Der1va/Flight/tmp/pdfs/schematic/page_1.png

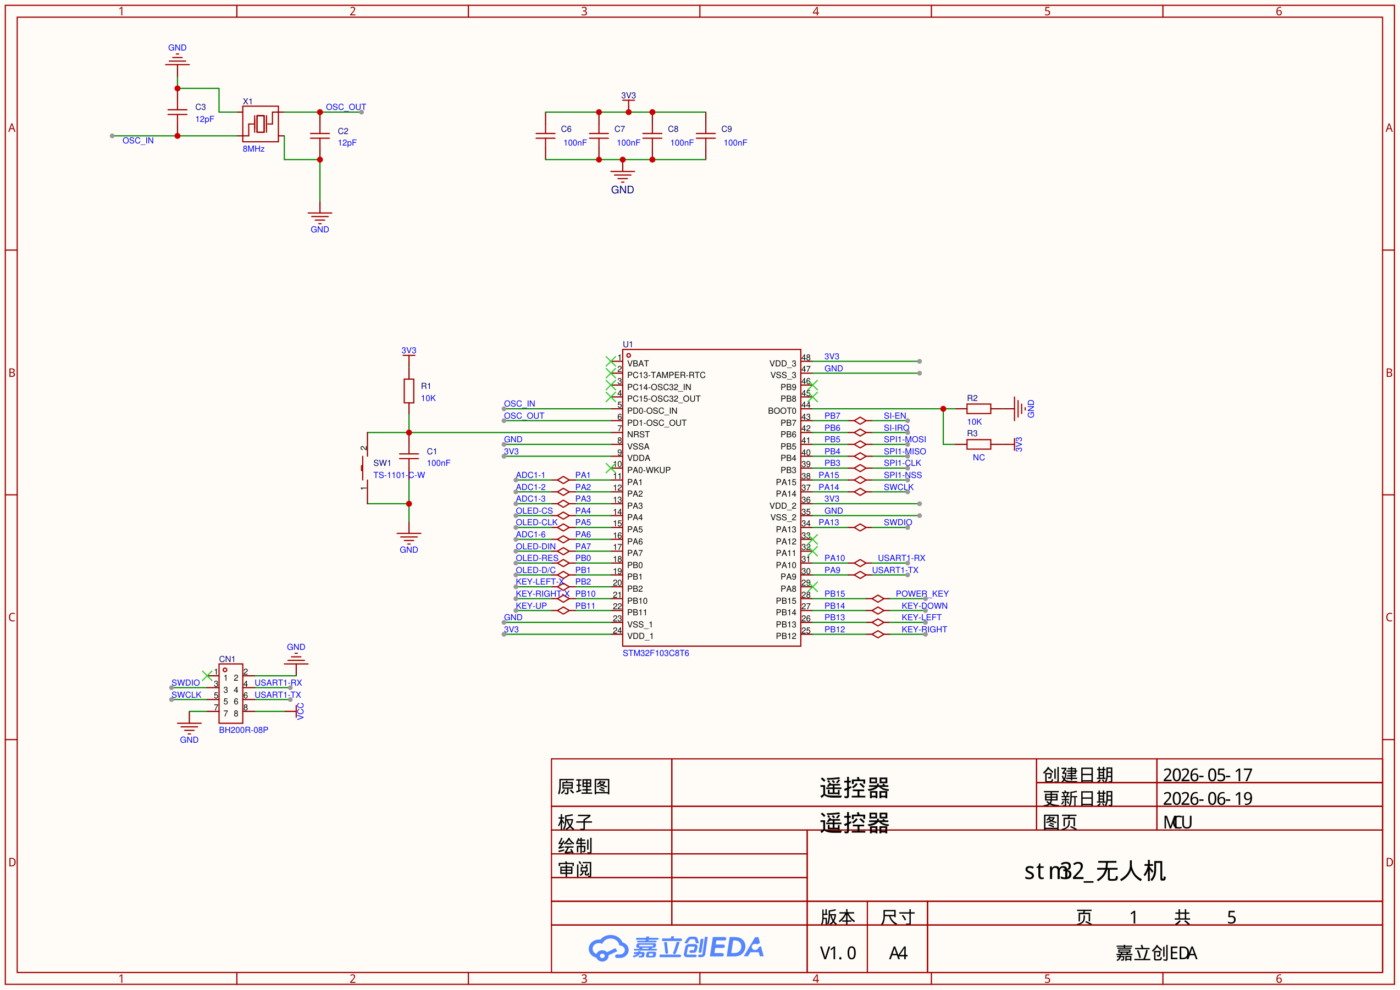
tmp/pdfs/schematic/page_1.png
