Der1va/Flight/tmp/pdfs/schematic/page_2.png

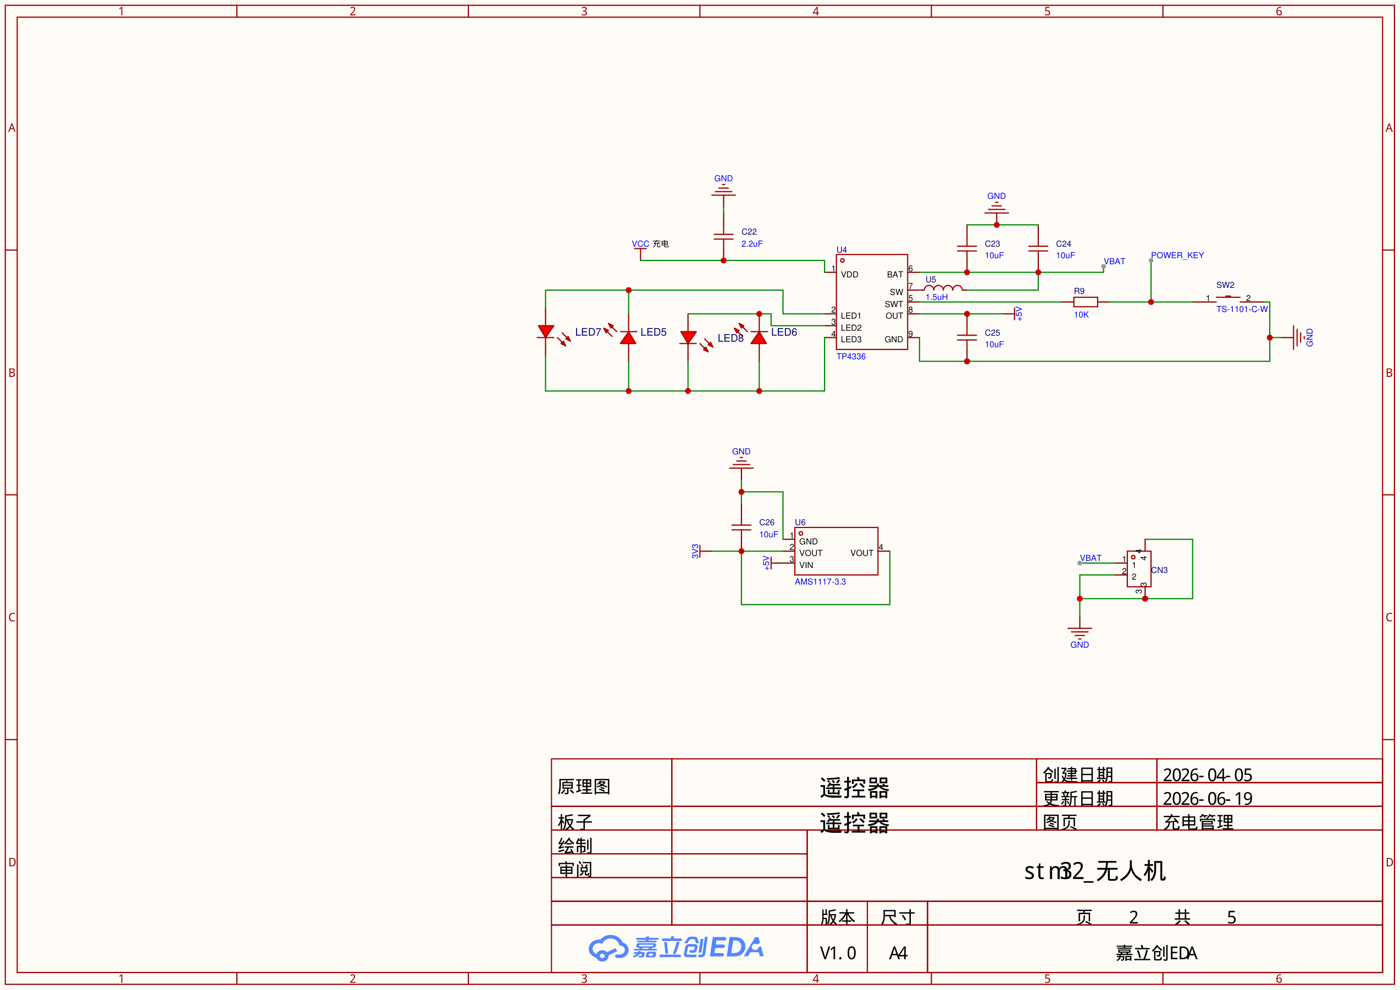
tmp/pdfs/schematic/page_2.png
