Der1va/Flight/tmp/pdfs/schematic/page_3.png

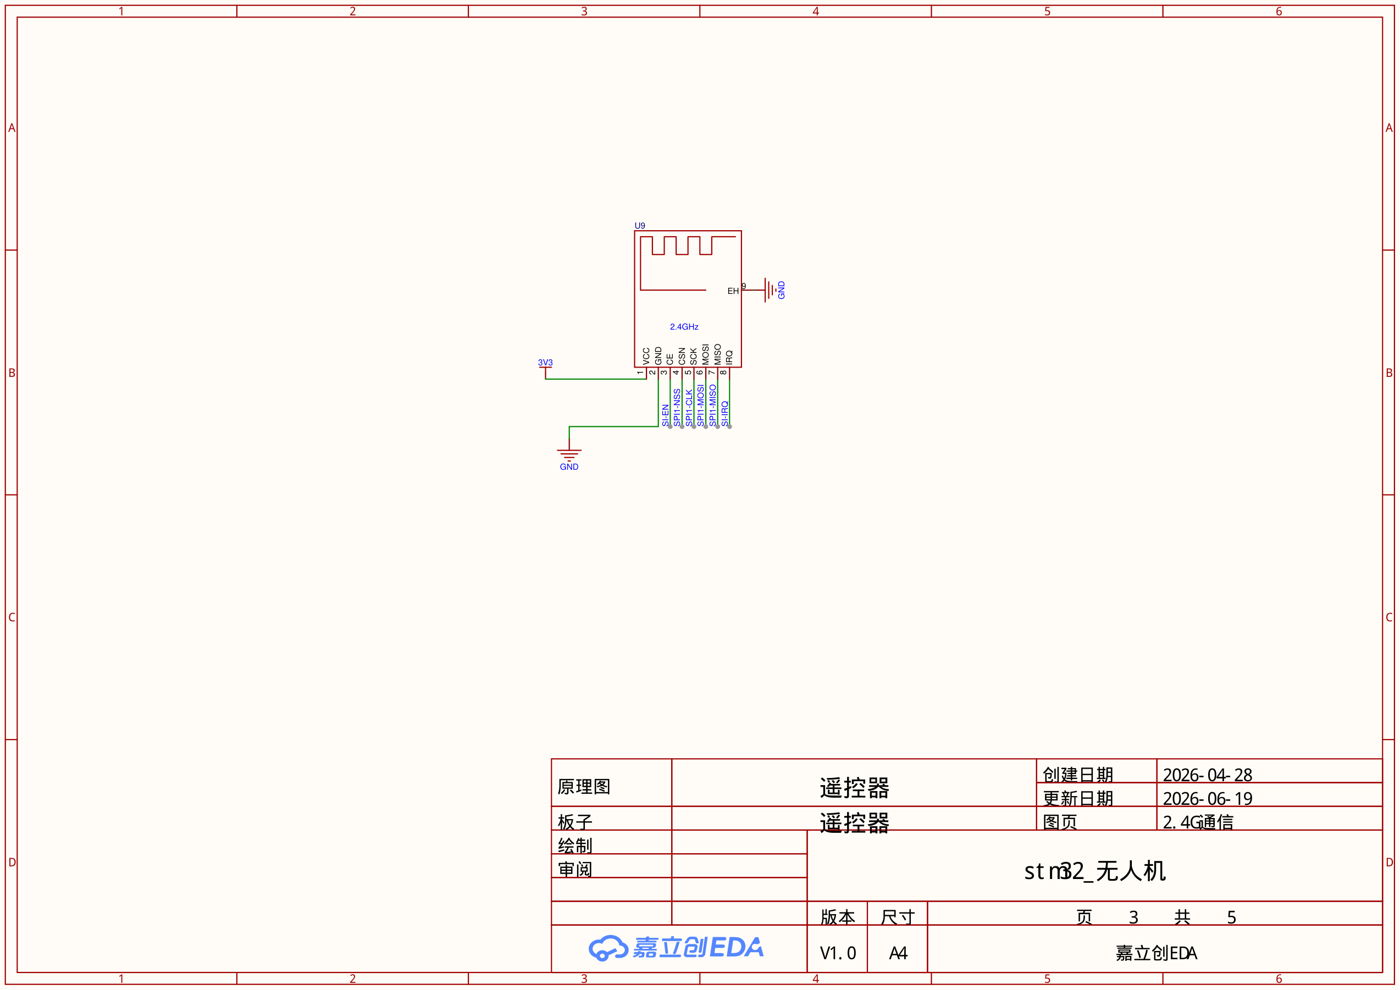
tmp/pdfs/schematic/page_3.png
