Der1va/Flight/tmp/pdfs/schematic/page_5.png

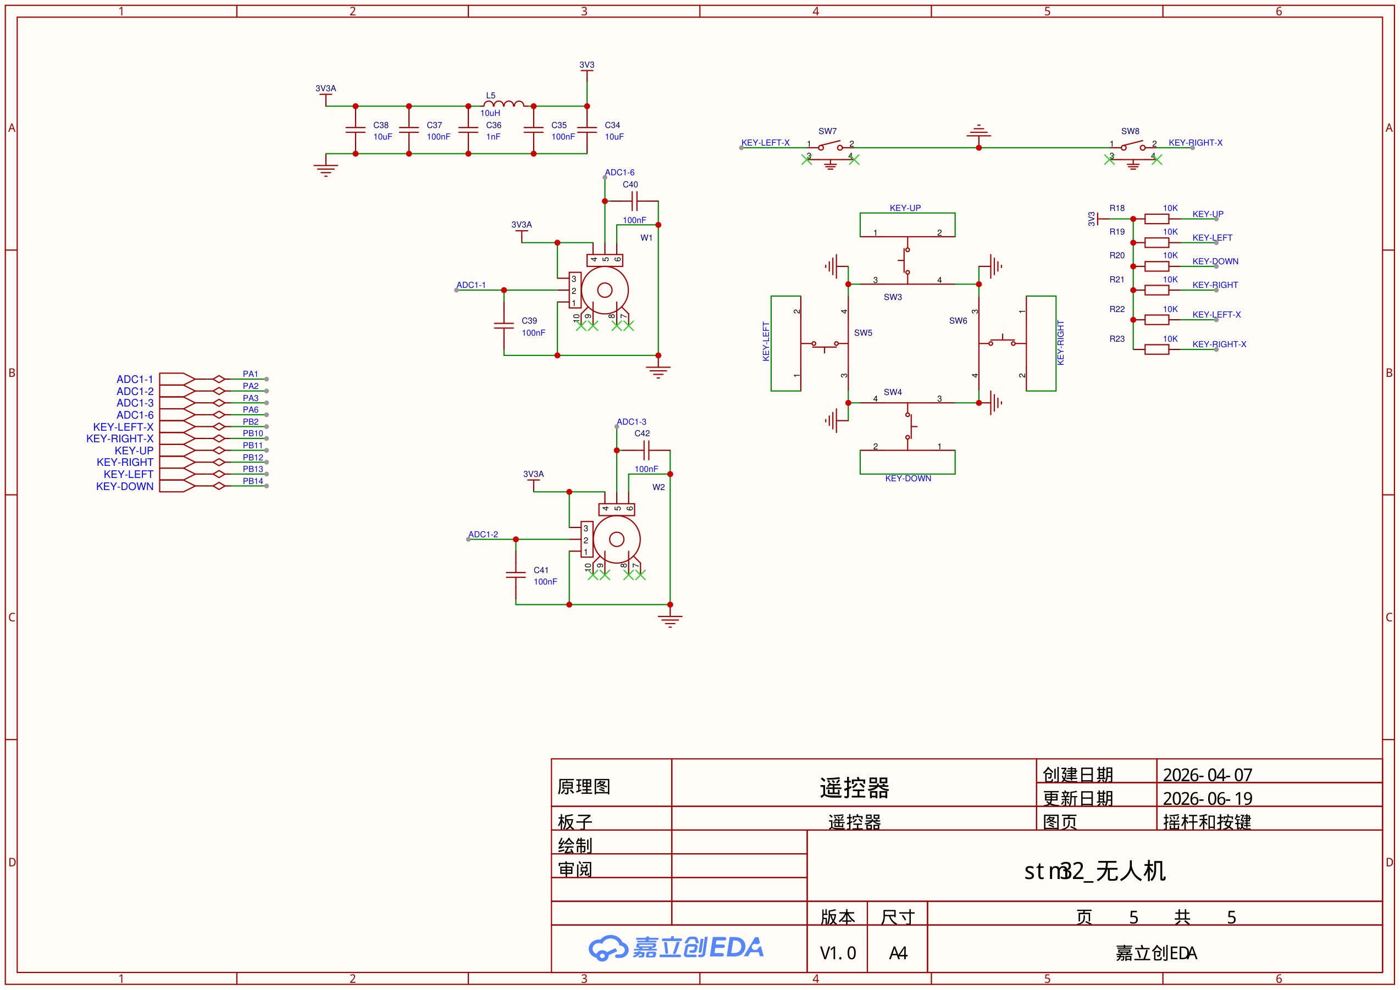
tmp/pdfs/schematic/page_5.png
