Der1va/Flight/Core/Src/main.c

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
/* Includes ------------------------------------------------------------------*/
#include "main.h"
#include "adc.h"
#include "dma.h"
#include "spi.h"
#include "usart.h"
#include "gpio.h"

/* USER CODE BEGIN Includes */
#include "common_debug.h"
#include "Application.h"
#include "Int_SI24R1.h"
/* USER CODE END Includes */


/* USER CODE BEGIN PV */
volatile TaskHandle_t g_stack_overflow_task = NULL;
volatile char *g_stack_overflow_task_name = NULL;

/* USER CODE END PV */

void SystemClock_Config(void);
/**
  * @brief  The application entry point.
  * @retval int
  */
int main(void)
{

  /* MCU Configuration--------------------------------------------------------*/

  /* Reset of all peripherals, Initializes the Flash interface and the Systick. */
  HAL_Init();

  /* Configure the system clock */
  SystemClock_Config();

  /* Initialize all configured peripherals */
  MX_GPIO_Init();
  MX_DMA_Init();
  MX_USART1_UART_Init();
  MX_SPI1_Init();
  MX_ADC1_Init();
  /* USER CODE BEGIN 2 */

  //完成日志输出的打印
  //HAL_UART_Transmit(&huart2, (uint8_t *)"Hello, World!\r\n", 15, HAL_MAX_DELAY);

  Int_SI24R1_Init();
  App_FreeRTOS_Start();

  /* USER CODE END 2 */

  /* Infinite loop */
  /* USER CODE BEGIN WHILE */
  while (1)
  {
    /* USER CODE END WHILE */

    /* USER CODE BEGIN 3 */
  }
  /* USER CODE END 3 */
}

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
/* USER CODE BEGIN 4 */
/* void vApplicationStackOverflowHook(TaskHandle_t xTask, char *pcTaskName)
{
  g_stack_overflow_task = xTask;
  g_stack_overflow_task_name = pcTaskName;

  __disable_irq();
  while (1)
  {
  }
} */

/* USER CODE END 4 */
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
