Der1va/Flight/Remote_Hal.ioc

Mcu.UserName=STM32F103C8Tx
PA1.Signal=ADCx_IN1
PA10.Signal=USART1_RX
PA13.Signal=SYS_JTMS-SWDIO
PA14.Signal=SYS_JTCK-SWCLK
PA15.GPIO_Label=SPI1-NSS
PA15.Signal=GPIO_Output
PA2.Signal=ADCx_IN2
PA3.Signal=ADCx_IN3
PA6.Signal=ADCx_IN6
PA9.Signal=USART1_TX
PB10.GPIO_Label=KEY_RIGHT_X
PB10.Signal=GPIO_Input
PB11.GPIO_Label=KEY_UP
PB11.Signal=GPIO_Input
PB12.GPIO_Label=KEY_RIGHT
PB12.Signal=GPIO_Input
PB13.GPIO_Label=KEY_LEFT
PB13.Signal=GPIO_Input
PB14.GPIO_Label=KEY_DOWN
PB14.Signal=GPIO_Input
PB15.GPIO_Label=POWER_KEY
PB15.Signal=GPIO_Output
PB2.GPIO_Label=KEY_LEFT_X
PB2.Signal=GPIO_Input
PB3.Signal=SPI1_SCK
PB4.Signal=SPI1_MISO
PB5.Signal=SPI1_MOSI
PB7.GPIO_Label=SI-EN
PB7.Signal=GPIO_Output
PC14-OSC32_IN.Signal=RCC_OSC32_IN
PC15-OSC32_OUT.Signal=RCC_OSC32_OUT
PD0-OSC_IN.Signal=RCC_OSC_IN
PD1-OSC_OUT.Signal=RCC_OSC_OUT
