Der1va/Flight/Interface/Int_KEY.c

#include "Int_KEY.h"

Key_TypeDef Int_KEY_get(void)
{
    if(HAL_GPIO_ReadPin(KEY_UP_GPIO_Port, KEY_UP_Pin) == GPIO_PIN_RESET)
    {
        vTaskDelay(10); //简单的消抖处理
        if(HAL_GPIO_ReadPin(KEY_UP_GPIO_Port, KEY_UP_Pin) == GPIO_PIN_RESET)
        {
            while(HAL_GPIO_ReadPin(KEY_UP_GPIO_Port, KEY_UP_Pin) == GPIO_PIN_RESET)
            {
                vTaskDelay(1);
            }
            return KEY_UP;
        }
    }
    else if(HAL_GPIO_ReadPin(KEY_DOWN_GPIO_Port, KEY_DOWN_Pin) == GPIO_PIN_RESET)
    {
        vTaskDelay(10);
        if(HAL_GPIO_ReadPin(KEY_DOWN_GPIO_Port, KEY_DOWN_Pin) == GPIO_PIN_RESET)
        {
            while(HAL_GPIO_ReadPin(KEY_DOWN_GPIO_Port, KEY_DOWN_Pin) == GPIO_PIN_RESET)
            {
                vTaskDelay(1);
            }
            return KEY_DOWN;
        }
    }
    else if(HAL_GPIO_ReadPin(KEY_LEFT_GPIO_Port, KEY_LEFT_Pin) == GPIO_PIN_RESET)
    {
        vTaskDelay(10);
        if(HAL_GPIO_ReadPin(KEY_LEFT_GPIO_Port, KEY_LEFT_Pin) == GPIO_PIN_RESET)
        {
            while(HAL_GPIO_ReadPin(KEY_LEFT_GPIO_Port, KEY_LEFT_Pin) == GPIO_PIN_RESET)
            {
                vTaskDelay(1);
            }
            return KEY_LEFT;
        }
    }
    else if(HAL_GPIO_ReadPin(KEY_RIGHT_GPIO_Port, KEY_RIGHT_Pin) == GPIO_PIN_RESET)
    {
        vTaskDelay(10);
        if(HAL_GPIO_ReadPin(KEY_RIGHT_GPIO_Port, KEY_RIGHT_Pin) == GPIO_PIN_RESET)
        {
            while(HAL_GPIO_ReadPin(KEY_RIGHT_GPIO_Port, KEY_RIGHT_Pin) == GPIO_PIN_RESET)
            {
                vTaskDelay(1);
            }
            return KEY_RIGHT;
        }
    }
    else if(HAL_GPIO_ReadPin(KEY_LEFT_X_GPIO_Port, KEY_LEFT_X_Pin) == GPIO_PIN_RESET)
    {
        TickType_t count1 = xTaskGetTickCount();
        vTaskDelay(10);
        if(HAL_GPIO_ReadPin(KEY_LEFT_X_GPIO_Port, KEY_LEFT_X_Pin) == GPIO_PIN_RESET)
        {
            while(HAL_GPIO_ReadPin(KEY_LEFT_X_GPIO_Port, KEY_LEFT_X_Pin) == GPIO_PIN_RESET)
            {
                vTaskDelay(1);
            }
            TickType_t count2 = xTaskGetTickCount();
            if(count2 - count1 > 1000) //长按超过1秒
            {
                return KEY_LEFT_X_LONG; //可以定义一个特殊的长按事件
            }
            else
            {
                return KEY_LEFT_X;
            }
        }
    }
    else if(HAL_GPIO_ReadPin(KEY_RIGHT_X_GPIO_Port, KEY_RIGHT_X_Pin) == GPIO_PIN_RESET)
    {
        TickType_t count1 = xTaskGetTickCount();
        vTaskDelay(10);
        if(HAL_GPIO_ReadPin(KEY_RIGHT_X_GPIO_Port, KEY_RIGHT_X_Pin) == GPIO_PIN_RESET)
        {
            while(HAL_GPIO_ReadPin(KEY_RIGHT_X_GPIO_Port, KEY_RIGHT_X_Pin) == GPIO_PIN_RESET)
            {
                vTaskDelay(1);
            }
            TickType_t count2 = xTaskGetTickCount();
            if(count2 - count1 > 1000) //长按超过1秒
            {
                return KEY_RIGHT_X_LONG; //可以定义一个特殊的长按事件
            }
            else
            {
                return KEY_RIGHT_X;
            }
        }
    }
    return KEY_NONE;
}
