Der1va/Flight/Interface/Int_IP5305T.c

#include "Int_IP5305T.h"
#include "FreeRTOS.h"
#include "task.h"

void Int_IP5305T_Start(void)
{
    HAL_GPIO_WritePin(POWER_KEY_GPIO_Port, POWER_KEY_Pin, GPIO_PIN_RESET);
    vTaskDelay(100);
    HAL_GPIO_WritePin(POWER_KEY_GPIO_Port, POWER_KEY_Pin, GPIO_PIN_SET);
}
